northbangkokspace/tusat-docs/tusat-docs/subsystems/ground-station.md

# Ground Station

### Detailed Pinout Diagram
Ground Station
