northbangkokspace/tusat-docs/tusat-docs/document.md

Block diagram documents can be downloaded [here](TUSat Block Diagram.pdf)<br/>
Assembly Procedure documents can be downloaded from [here](TU_Sat_Assembly-Procedure.docx)<br/>
Structural Analysis can be downloaded [here](KTR Structural Analysis(1.5U).docx)<br/>
Structure Design File can be downloaded [here](TU-Sat Sim.step)<br/>
Subsystem Tests image can be found [here](https://drive.google.com/drive/folders/1vS2rQoHUuQP6zxkLRVOEXOmQFG0e9m5K?usp=drive_link)
