northbangkokspace/tusat-docs/tusat-docs/images/arduino.png

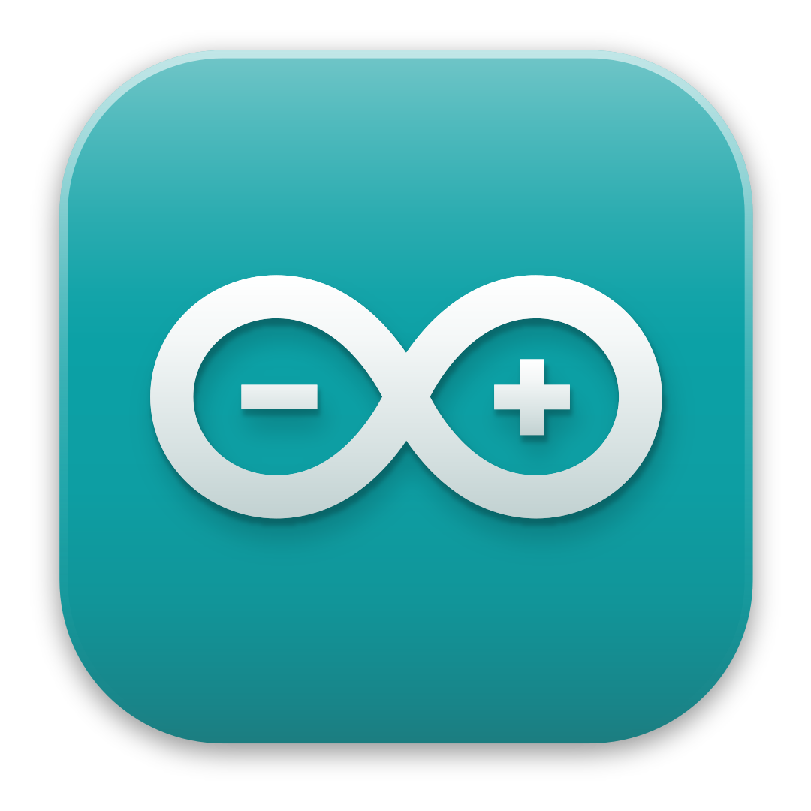
tusat-docs/images/arduino.png
