northbangkokspace/tusat-docs/tusat-docs/TU-Sat Sim.step

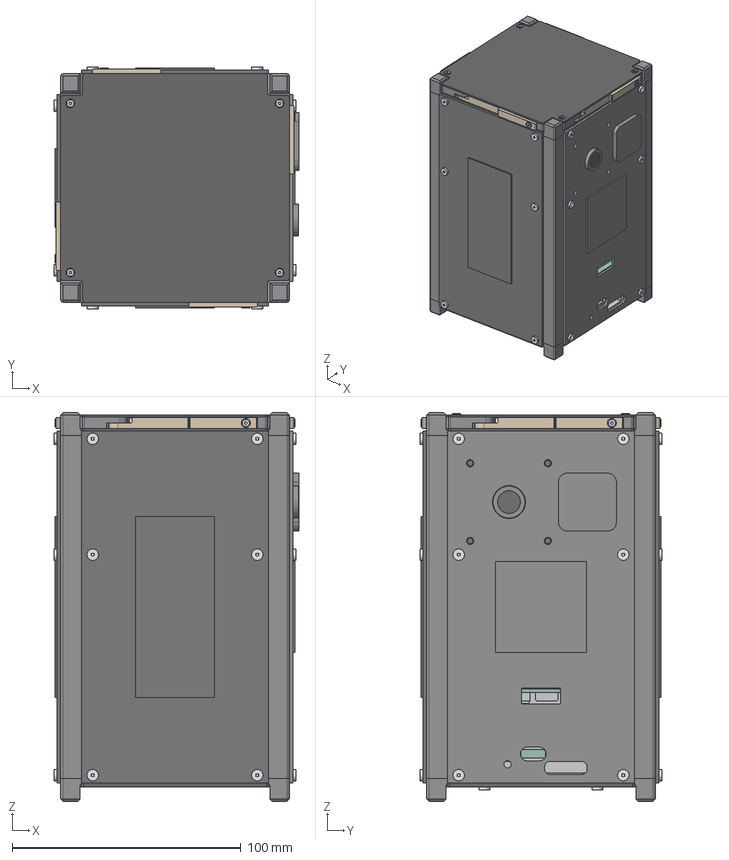
[picture p18: CAD file, 2025-10-13]
tusat-docs/TU-Sat Sim.step
107.1 x 105.8 x 170.2 mm
1.5U_Base
SideFrame 1.5U x 4
1.5U_Top
Spacer Axis x 3
EPS_Bottom_Enclosure
EPS_Top_Enclosure
PCB OBC
_T1SSQ-126-23-G-D x 2
_P2SSQ-126-23-G-D x 2
M1259-3005-AL-0 M3x12 x 4
M2142-3005-AL-0 M3x7 x 4
Tu-COMM-OBC Base
Tu-COMM-OBC Top
ESQ-126-39-G-D-LL_bpins x 4
ESQ-126-39-G-D_pins x 4
ESQ-126-39-G-D_socket x 4
Tu-MTQ Base
Coil x 2
Air_coil
pcb_lock x 2
PTFE_Headlock x 4
Torque_rod_6.3_70 x 2
Board_Lock
Board_Lock_2ways_v4_order.step
TU-Sat_Payload_Base
TU-Sat_Payload_Top
Payload PCB
Sensor Holder
antenna frame for education project
PCB Test Board
Feeder x 4
Cover
Door 1.3 x 4
SSTS-M2.5-8 x 8
CBSTSE2-6 x 18
Innomaker_OV9281
001_ROUND_HEX_STANDOFFS x 4
Solar_Panel x 3
Solar_Panel_Z
Spacer 61 x 4
M0543-3-AL-0 14mm x 4
SSTS-M2.5-5 x 28
CBSTSR2.5-3 x 16
