northbangkokspace/tusat-docs/tusat-docs/GS/GND_Receive/GND_Receive.ino

/*
  RadioLib SX127x Blocking Receive Example

  This example listens for LoRa transmissions using SX127x Lora modules.
  To successfully receive data, the following settings have to be the same
  on both transmitter and receiver:
  - carrier frequency
  - bandwidth
  - spreading factor
  - coding rate
  - sync word
  - preamble length

  Other modules from SX127x/RFM9x family can also be used.

  Using blocking receive is not recommended, as it will lead
  to significant amount of timeouts, inefficient use of processor
  time and can some miss packets!
  Instead, interrupt receive is recommended.

  For default module settings, see the wiki page
  https://github.com/jgromes/RadioLib/wiki/Default-configuration#sx127xrfm9x---lora-modem

  For full API reference, see the GitHub Pages
  https://jgromes.github.io/RadioLib/
*/

// include the library
#include <RadioLib.h>

// SX1278 has the following connections:
// CS Pin => D10, PB6
// D0 Pin => D2, PA10
// RST Pin => D9, PC7
// D1 Pin => D7, PA8

SPIClass RADIO_SPI(PA7, PA6, PA5, -1);
SX1278 radio = new Module(PB6, PA10, PC7, -1, RADIO_SPI);

// SX1278 radio = new Module(PB6, PA10, PC7, PA8); // Change D1 Pin

// or detect the pinout automatically using RadioBoards
// https://github.com/radiolib-org/RadioBoards
/*
#define RADIO_BOARD_AUTO
#include <RadioBoards.h>
Radio radio = new RadioModule();
*/

volatile bool receivedFlag = false;

void setFlag(void) {
  receivedFlag = true;
}

void setup() {
  Serial.setTx(PA2);
  Serial.setRx(PA3);
  Serial.begin(115200);
  // initialize SX1278 with default settings
  Serial.print(F("[SX1278] Initializing ... "));
  RADIO_SPI.begin();
  int state = radio.beginFSK(435);
  // state += radio.setDataShaping(RADIOLIB_SHAPING_0_5);
  // state += radio.setFrequencyDeviation(1.2);
  state += radio.setOutputPower(15);
  uint8_t syncWord[] = { 0x01, 0x23, 0x45, 0x67,
                         0x89, 0xAB, 0xCD, 0xEF };
  state = radio.setSyncWord(syncWord, 8);
  if (state == RADIOLIB_ERR_NONE) {
    Serial.println(F("success!"));
  } else {
    Serial.print(F("failed, code "));
    Serial.println(state);
    while (true) { delay(10); }
  }
  
  // Bind hardware transceiver event to ISR flag
  radio.setDio0Action(setFlag, RISING);

  // Trigger background reception
  int state_rx = radio.startReceive();
  if (state_rx == RADIOLIB_ERR_NONE) {
    Serial.println(F("[SYSTEM] RF Interrupt enabled. Listening..."));
  } else {
    Serial.print(F("[ERROR] Failed to start receive. Code: "));
    Serial.println(state_rx);
  }
}
#define RECEIVE 1

#if defined(TRANSMIT)
int count = 0;

void loop() {
  Serial.print(F("[SX1278] Transmitting packet ... "));

  // you can transmit C-string or Arduino string up to
  // 255 characters long
  String str = "Hello World! #" + String(count++);
  int state = radio.transmit(str);

  // you can also transmit byte array up to 256 bytes long
  /*
    byte byteArr[] = {0x01, 0x23, 0x45, 0x67, 0x89, 0xAB, 0xCD, 0xEF};
    int state = radio.transmit(byteArr, 8);
  */

  if (state == RADIOLIB_ERR_NONE) {
    // the packet was successfully transmitted
    Serial.println(F(" success!"));

    // print measured data rate
    Serial.print(F("[SX1278] Datarate:\t"));
    Serial.print(radio.getDataRate());
    Serial.println(F(" bps"));

  } else if (state == RADIOLIB_ERR_PACKET_TOO_LONG) {
    // the supplied packet was longer than 256 bytes
    Serial.println(F("too long!"));

  } else if (state == RADIOLIB_ERR_TX_TIMEOUT) {
    // timeout occurred while transmitting packet
    Serial.println(F("timeout!"));

  } else {
    // some other error occurred
    Serial.print(F("failed, code "));
    Serial.println(state);
  }

  // wait for a second before transmitting again
  delay(1000);
}





#elif defined(RECEIVE)
void loop() {
  if (receivedFlag) {
    receivedFlag = false; // Reset flag

    String str;
    int state = radio.readData(str);

    if (state == RADIOLIB_ERR_NONE) {
      // packet was successfully received
      Serial.println(F("success!"));

      // print the data of the packet
      Serial.print(F("[SX1278] Data:\t\t\t"));
      Serial.println(str);

      // print the RSSI (Received Signal Strength Indicator)
      // of the last received packet
      Serial.print(F("[SX1278] RSSI:\t\t\t"));
      Serial.print(radio.getRSSI());
      Serial.println(F(" dBm"));

      // print the SNR (Signal-to-Noise Ratio)
      // of the last received packet
      Serial.print(F("[SX1278] SNR:\t\t\t"));
      Serial.print(radio.getSNR());
      Serial.println(F(" dB"));

      // print frequency error
      // of the last received packet
      Serial.print(F("[SX1278] Frequency error:\t"));
      Serial.print(radio.getFrequencyError());
      Serial.println(F(" Hz"));

    } else if (state == RADIOLIB_ERR_CRC_MISMATCH) {
      // packet was received, but is malformed
      Serial.println(F("CRC error!"));

    } else {
      // some other error occurred
      Serial.print(F("failed, code "));
      Serial.println(state);
    }
    
    // Reactivate non-blocking hardware receiver state
    radio.startReceive();
    receivedFlag = false;
  }
}

#else
#error "Define TRANSMIT or RECEIVE"
#endif
